mystorm-org/BlackIce-II/README.md

# BlackIce-II

Project documentation can be found in the [project wiki](https://github.com/mystorm-org/BlackIce-II/wiki).
