mystorm-org/BlackIce-II/examples/readme.md

# Examples

* blink

	Blink one LED

* alternate
* button
* count
* position
* random
* rotate

* hello\_world

    FPGA continuously sends "Hello World!" to the serial USB port.

* uart\_loopback

    FPGA receives data from USB2, decodes it, and retransmits it to USB2.

* sram

    An example that shows how to make the FPGA use the external SRAM.

* pll

    An example that shows how to use a PLL to create different clocks.

* pll\_advanced

    A lot more PLL examples.
