mystorm-org/BlackIce-II/examples/hello_world/readme.md

# Hello World!

This example blinks LED1 roughly once every 1.5 seconds.

The design contains a very simply UART TX block.  Whenever the LED blinks, the FPGA also sends "Hello World!" to the USB2 port.

Run "make help" to check out the available options.
