mystorm-org/BlackIce-II/hardware/mystorm.png

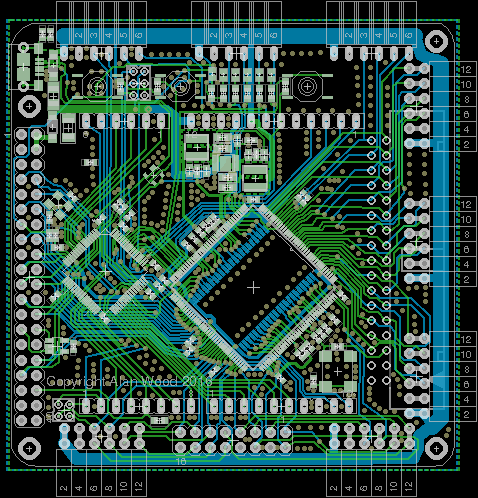
hardware/mystorm.png
