mystorm-org/BlackIce-II/(threads)

Thread 4 (2018-02-24):

Downloading a bitstream over /dev/ttyUSB0 defeatured?

tomverbeure, 2018-02-24:
### Executive summary:

Has bitstream downloading over /dev/ttyUSB0 been defeatured?

If so, this should probably be made more clear!

### The Long Story:

There are plenty of places that mention that you can download a bitstream via both /dev/ttyACM0 (which works for me) and /dev/ttyUSB0.

Here's one such case:
https://gist.github.com/mattvenn/293c3007fae978cfb3c3eb81c7464349

The iceboot source code says the same as well. As can be seen here:
https://github.com/mystorm-org/BlackIce-II/blob/3051631468404d1505e2d82c021b8d2c9acc7d34/firmware/iceboot/iceboot.c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
and here:
https://github.com/mystorm-org/BlackIce-II/blob/3051631468404d1505e2d82c021b8d2c9acc7d34/firmware/iceboot/iceboot.c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

The problem is: I just can't get it to work.

After doing ```stty -F /dev/ttyUSB0 115200```, ```stty -F /dev/ttyUSB0 raw```, and pressing the reset button, I see the following just fine:
```
root@ubuntu-xenial:~/projects/BlackIce-II-mine/examples/blink# cat /dev/ttyUSB0
<Iceboot 0.4>
Setup done
```

And doing ```sudo cat chip.bin > /dev/ttyUSB0``` returns after a while, so I think that's executing fine as well.

But no bitstream is being updated.

Diving further into the ```iceboot``` source code, I see the following in ```setup()```:
https://github.com/mystorm-org/BlackIce-II/blob/3051631468404d1505e2d82c021b8d2c9acc7d34/firmware/iceboot/iceboot.c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

And:
https://github.com/mystorm-org/BlackIce-II/blob/3051631468404d1505e2d82c021b8d2c9acc7d34/firmware/iceboot/iceboot.c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

And in ```loop()```, I don't see anything that's actually accessing the real UART.

So my current conclusion is that this feature simply doesn't exist anymore.

Is that correct?

Thanks!
Tom

folknology, 2018-02-24:
I think Matt Venn's excerpt from ken is rather old (notice the mystorm 0.1). Originally we had no native STM32 USB and had to use either serial adaptors or later the USB/Serial chips like the CH340. Now however with the Native USB via the STM32 we do not need the extra serial adaptor to program the Ice40 bitfile. However many folks frequently build in Uarts as part of their FPGA projects, Thus this becomes the prime use of the 2nd USB feature, we have actively de-featured it on BlackIce II, as it is now hardwired into PMOD1 and the FPGA. It is also still connected to the STM32 and can be used by user programs if they so wish, but for our standard firmware it is unlikely to be activated moving forward.

tomverbeure, 2018-02-24:
Ok!  So my understanding is correct then.

I've already indicated in the documentation that the /dev/ttyUSB0 method doesn't work anymore.

Closing.

Closed 2018-02-24.

Thread 7 (2018-02-25):

Seperate VBUS for both USB connections

folknology, 2018-02-25:
VBUS is currently shared between the two usb connectors, add a diode so each feeds separately to supply.

Thread 10 (2018-03-01):

Update schematic pdf for incorrect and missing items

tomverbeure, 2018-03-01:
* Rename: STM32F103RET6 -> STM32L433RCT6
* Rename: IS62WV25616DBLL-10TLI -> IS61WV25616EDBLL-10TLI
* Add: SN74CBTLV3257 (If that's the one...)

Bonus points: provide PDFs of the PCB and the component placements.

Thread 14 (2018-03-06):

"assign my_signal = 1'bz;" doesn't do what you think it does.

tomverbeure, 2018-03-06:
See the Yosys issue that I just filed:
https://github.com/YosysHQ/yosys/issues/511

```assign my_signal = 1'bz;``` results in an active low output driver.

All current examples are using this for all unused PMOD and other signals.

As a result, a bunch of IOs on the board may be in short-circuit state.

The best example of this is ```PMOD[1]/greset```: this signal is always driven by the CH340G RTS# signal, and it drives a value of 1 (at least when when USB2 is not plugged in). In all examples, ```PMOD[1] = 1'bz```, so it drives a low.

Apparently, the FPGA is a stronger driver than the CH340G on my board, because otherwise no example would work with ```greset``` driving a 1.

Tom

Note: when I fix the issue by not assigning anything to PMOD1, the board is indeed in reset at all times, except when I do "cat /dev/ttyUSB0" or "echo <blah> > /dev/ttyUSB0". But as soon as I cancel the 'cat' operation or as soon as the echo is completed, it goes back into reset.

tomverbeure, 2018-03-10:
Since constant assignments of 1'bz simply don't work, and actually do active harm, they shouldn't be done at all.

What also doesn't work is to keep the output ports but not assign them: that also results in a hard drive to 0. As can be seen in this post-placement result from Arachne:
```
  SB_IO #(
    .PIN_TYPE(6'b011001)
  ) $inst0 (
    .PACKAGE_PIN(B1),
    .D_OUT_0($undef)
  );
```

Also not a good solution: do nothing. Having IOs constantly in contention is just not a good idea.

Here are possible solutions:
* No assignments and no port declarations. I believe that this results in IOs that default to input, with pulp enabled. This is my preference. (Example fix is here: https://github.com/tomverbeure/BlackIce-II/tree/fix_contentions)
* No assignments, but change outputs to inputs. This results in an instantiated IO port that's explicitly set to input, but without pullup:
```
  SB_IO #(
    .PIN_TYPE(6'b000001)
  ) $inst0 (
    .PACKAGE_PIN(B1)
  );
```
* Expliclity instantiate SB_IOs for all unused port.

folknology, 2018-03-27:
I like your fix contentions for the reset (the `assign my_signal = 1'bz;` is a PITA) it is a great idea to sort this out generically for all examples. Perhaps if we use -no-warn on the set_ios ( #9 ) we could remove all other none used io's from the examples?

folknology, 2018-03-29:
Maybe we just use 'inout' rather than 'out' in all cases of tri-stating

folknology, 2018-03-29:
I'm having trouble checking this, just updated yosy after some installation issues on my laptop (I'm remote at the mo), but tri-stating is complicated with yosys - This is an interesting thread around the matter https://github.com/cseed/arachne-pnr/issues/24

folknology, 2018-03-29:
I'm playing around with some of the examples to find a better expression for these

TimRudy, 2021-03-06:
Is this resolved by fix of https://github.com/YosysHQ/yosys/issues/1841, which was generic, in iopadmap?
Just checking in 2021.

tomverbeure, 2021-03-06:
I just reran this as follows:

```
read_verilog test.v
hierarchy
synth_ice40
write_blif test.blif
write_verilog test.out.v
```

And the output was this:
```verilog
(* top =  1  *)
(* src = "test.v:1.1-13.10" *)
module tritest(my_tri_out, my_tri_inout, my_in0, my_in1);
  (* src = "test.v:5.15-5.21" *)
  input my_in0;
  (* src = "test.v:6.15-6.21" *)
  input my_in1;
  (* src = "test.v:3.15-3.27" *)
  inout my_tri_inout;
  (* src = "test.v:2.16-2.26" *)
  output my_tri_out;
  (* src = "test.v:11.31-11.53" *)
  \$_TBUF_  \my_tri_inout_$_TBUF__Y  (
    .A(my_in1),
    .E(my_in0),
    .Y(my_tri_inout)
  );
  assign my_tri_out = 1'hz;
endmodule
```

The `my_tri_out = 1'hz;` is still there.

In my own designs, I pretty much always instantiate IO buffers when I want anything other than pure input or output, so this bug is not an issue for me anymore.

Tom

Thread 23 (2018-03-27):

Optimisation of SRAM memory pinout for subsequent BlackIce revisions

folknology, 2018-03-27:
I notice @lawrie has a  [desire](https://github.com/mystorm-org/BlackIce-II/tree/master/examples/sram) for certain signals RAM_OE and WE being in different groups to enable use of inverted clock function in IO section. However the linked solution ends up using the DDR mode in order to solve the timing issues in another way which may well be more flexible. This therefore is a temporary place holder discussions about any potential optimisations of the SRAM-Ice40 current pinout choices including issues described in the link.  Feel free to discuss..

Thread 25 (2018-08-11):

BlackIce-I support

expipiplus1, 2018-08-11:
I've got a BlackIce-I board (Not sure precisely which revision. I've compiled the firmware and blink examples in this repository and they seem to be working. The post here: https://mystorm.uk/blackice-build-update/ says that some pin assignments have been reassigned. Hopefully the only change necessary will be to use a different pcf file.

Would it make sense to add the original blackice.pcf (found [here](https://github.com/mystorm-org/Guide/blob/master/tutorial/blink/blackice.pcf)) to this repo and make it an option when building?

victzh, 2019-04-17:
I second this. I have Blackice-I board also and I tried to build examples. I built blink example, but it requires not only .pcf file, but chip.v from the same project as well.

Also, it is mentioned somewhere that because of conflict with RAM some PLL modes are unavailable for it. I would like to know more details about it as well.

Thread 26 (2019-12-06):

PicoRV32 example?

sunnystormy, 2019-12-06:
Hello! I've still got my BlackIce-II board and am trying to get Clifford Wolf's PicoRV32 running on it. I'm running into some problems with getting next-pnr to create an "hx4k" pathway (I know that the tutorials recommend arachne-pnr, but that seems to have been deprecated).

If you have any recommendations for getting a risc-v core running on the board, I'd love to hear it! Thank you for your help!

lawrie, 2019-12-06:
--hx8k --package tq144:4k

works for me.

sunnystormy, 2019-12-07:
So, I've modified the Makefile that comes with picorv32 to include the options you've provided, and I end up with:

```
nextpnr-ice40 --hx8k --package tq144:4k --json synth.json --pcf example.pcf --asc example.asc
Info: Importing module top
Info: Rule checker, verifying imported design
Info: Checksum: 0x6c59d296

ERROR: package does not have a pin named 'J3' (on line 1)
ERROR: Loading PCF failed.
0 warnings, 2 errors
make: *** [Makefile:35: example.asc] Error 255
```

Any idea why this is happening? Is it because the pcf file may have the wrong pin configuration?

Thank you for your help!

lawrie, 2019-12-07:
Yes, you were using the wrong pcf file for the Blackice II board.

sunnystormy, 2019-12-07:
@lawrie Thank you for this! I'll move the conversation to a more appropriate venue, as per your suggestion.

Thread 27 (2024-07-30):

Issues with SRAM example

bonnefoi, 2024-07-30:
Hello,

I've a lot of issues with the SRAM example with the io constraints like `sram_addr_to_pad` not known.

When I try to change it to `ADR` in the file `sram_io_ice40`, I've got an error:
`chip.blif:322: fatal error: toplevel inout port 'ADR[0]' connected to tristate buffer and driving a net`

I know that is old tech by now, but I would like to use SRAM for my PicoRV32 that uses only ~12k of BRAM currently.

Let me know if you could help me.
Best regards,
Pierre-Francois.

chenz, 2024-07-30:
I've had issues before with the examples not working with newer versions of the toolchain.

E.g. with Yosys 0.27, I had to add "-top chip" in the Makefile, because it would no longer pick "chip" implicitly as the top level module.

Also, arachne-pnr is still being used in the Makefile, which has been unmaintained for a while so it would not be surprising that it does not work with more recent Yosys output.  You could try to use nextpnr instead.

bonnefoi, 2024-07-31:
Thank you very much for your answer !

I've already encountered the issue with the automatic selection of the top circuit with newer version of yosys, but stupid me, I've tried `-top top`...

It's working now and I can now start to connect it to the SoC.
