mystorm-org/BlackIce-II/hardware/BlackIce.pdf

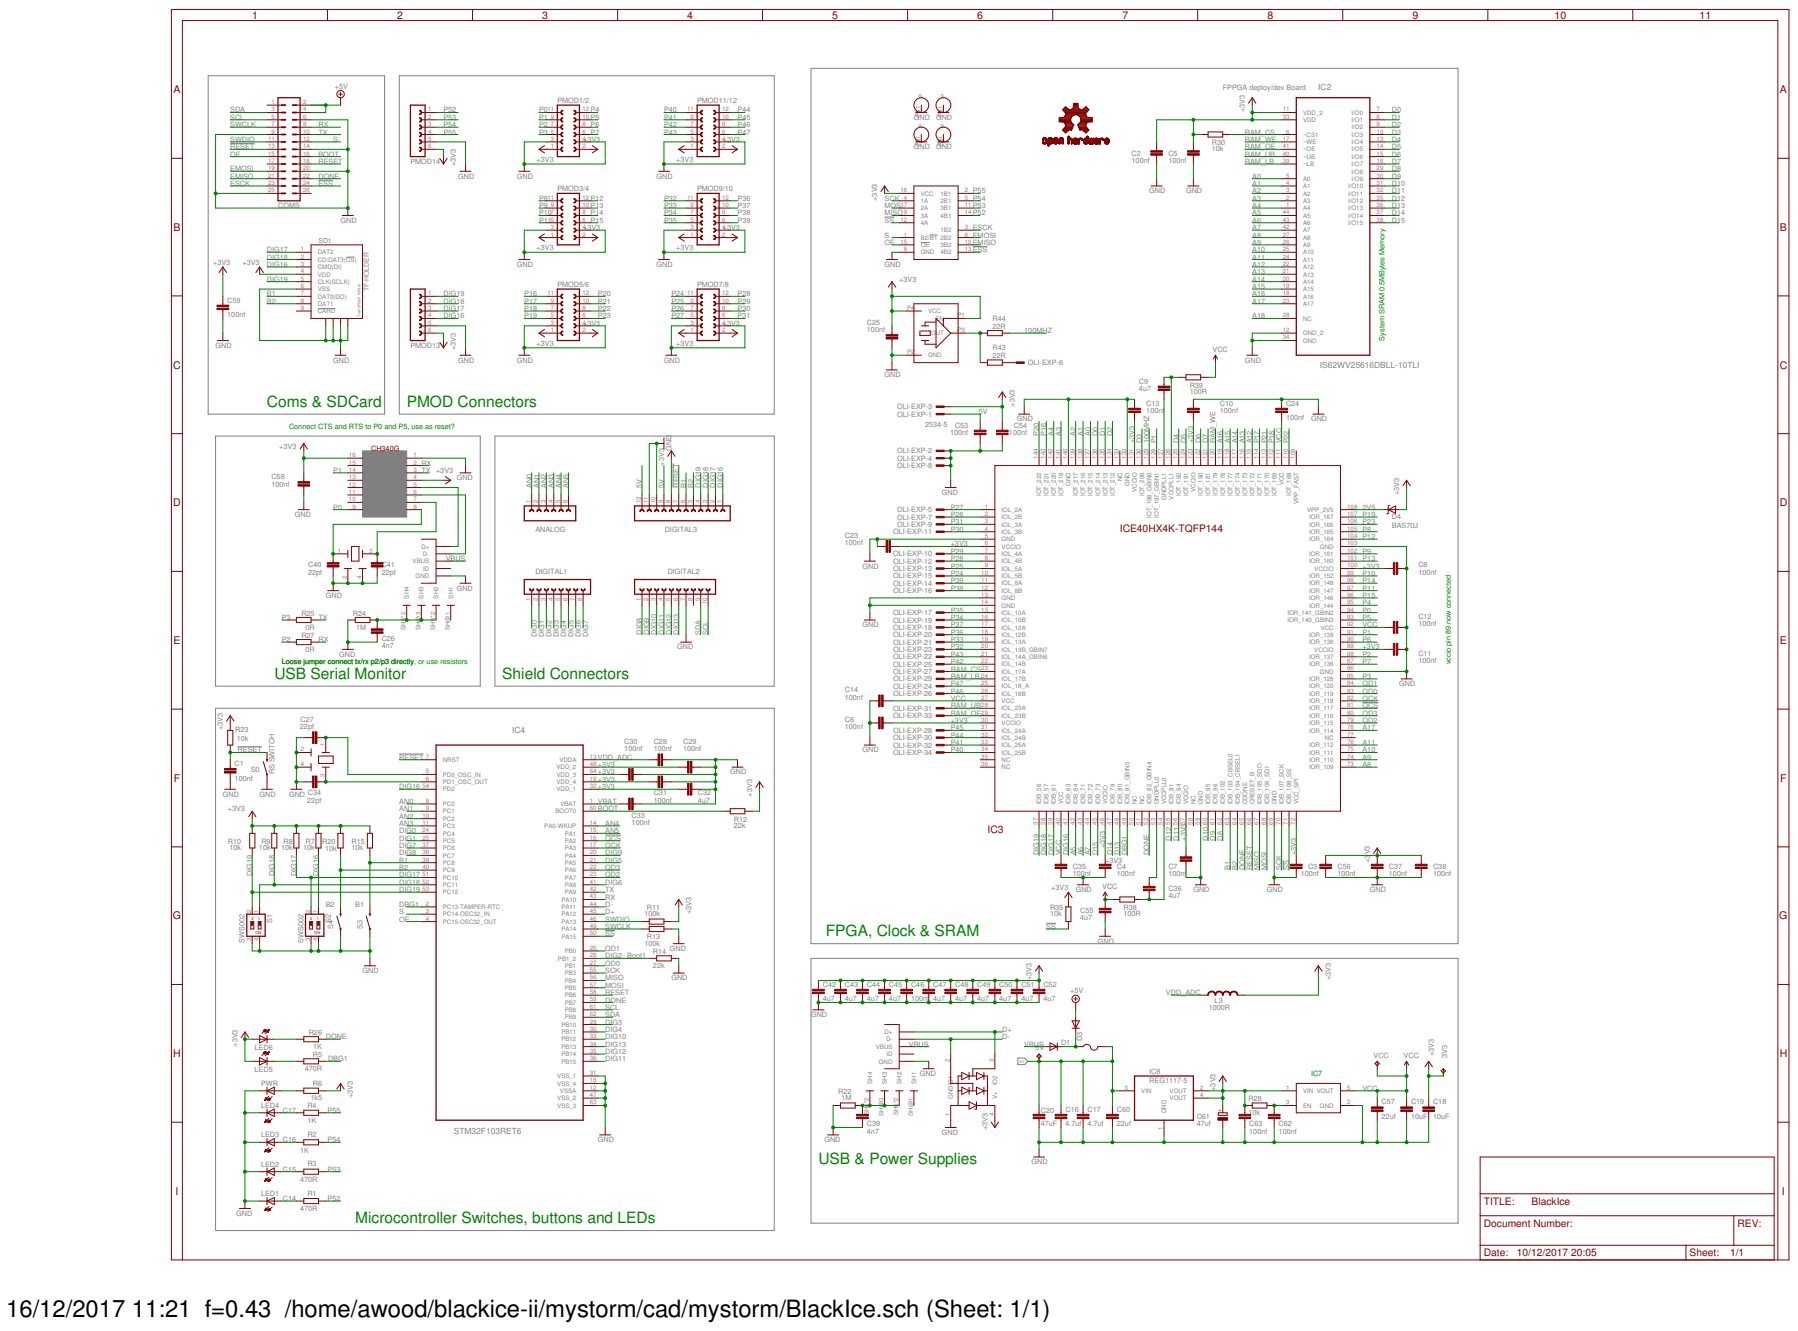
[picture p3: page 1]

FPPGA deploy/dev Board

OLI-EXP-1 OLI-EXP-2 OLI-EXP-3 OLI-EXP-4 OLI-EXP-5

Connect CTS and RTS to P0 and P5, use as reset?

OLI-EXP-8 OLI-EXP-9 OLI-EXP-10 OLI-EXP-11 OLI-EXP-12

IOL_2A
IOL_2B
IOL_3A
IOL_3B
IOL_4A
IOL_4B
OLI-EXP-13 OLI-EXP-15 OLI-EXP-14 OLI-EXP-16 OLI-EXP-17 OLI-EXP-19 OLI-EXP-18 OLI-EXP-20 OLI-EXP-21 OLI-EXP-23 OLI-EXP-27 OLI-EXP-29 OLI-EXP-31 OLI-EXP-33 OLI-EXP-32 OLI-EXP-34

vccio pin 89 now connected

Loose jumper connect tx/rx p2/p3 directly, or use resistors
USB Serial Monitor

16/12/2017 11:21 f=0.43 /home/awood/blackice-ii/mystorm/cad/mystorm/BlackIce.sch (Sheet: 1/1)
