mystorm-org/BlackIce-II/examples/pll_advanced/dual_pll_4clocks/pll.v

module pll_top(
	input  clock_in,
	output clock_out_a,
	output clock_out_b,
	output locked
	);

SB_PLL40_2_PAD #(
		.FEEDBACK_PATH("SIMPLE"),
		.DIVR(4'b0100),		// DIVR =  4
		.DIVF(7'b0101111),	// DIVF = 47
		.DIVQ(3'b101),		// DIVQ =  5
		.FILTER_RANGE(3'b010),	// FILTER_RANGE = 2
	) uut (
		.LOCK(locked),
		.RESETB(1'b1),
		.BYPASS(1'b0),
		.PACKAGEPIN(clock_in),
		.PLLOUTGLOBALA(clock_out_a),
		.PLLOUTGLOBALB(clock_out_b)
		);

endmodule

module pll_bottom(
	input  clock_in,
	output clock_out_a,
	output clock_out_b,
	output locked
	);

SB_PLL40_2F_CORE #(
		.FEEDBACK_PATH("SIMPLE"),
		.DIVR(4'b0100),		// DIVR =  4
		.DIVF(7'b0011111),	// DIVF = 31
		.DIVQ(3'b101),		// DIVQ =  5
		.FILTER_RANGE(3'b010),	// FILTER_RANGE = 2
		.PLLOUT_SELECT_PORTB("GENCLK_HALF")
	) uut (
		.LOCK(locked),
		.RESETB(1'b1),
		.BYPASS(1'b0),
		.REFERENCECLK(clock_in),
		.PLLOUTGLOBALA(clock_out_a),
		.PLLOUTGLOBALB(clock_out_b)
		);

endmodule
