mystorm-org/BlackIce-II/(commit log)

2017-12-23 Added blackIce-II version of iceboot (0.4) , sourcecode and hardware etc..
    [BlackIce.brd, BlackIce.sch, BlackIce_11_10_17.brd, BlackIce_11_10_17.sch, stlink.cfg]
2017-12-23 Update tutorials to use common PCF file, updated BlackIce-II pcf file, fixed button tutorials
    [blackice-ii.pcf, button.v, chip.v]
2018-02-24 Add pin definitions for quad SPI pins.
2018-02-24 Change upload device from /dev/ttyUSB0 to /dev/ttyACM0
2018-02-25 hello world uart_tx example
2018-02-27 uart_loopback example
2018-02-27 Add uart_loopback
2018-03-05 Remove UART from SRAM example.
2018-03-05 Remove uart blocks.
2018-03-05 Button 2 corrupts the SRAM read data
2018-03-24 Fix the comment: the oscillator is actually 100 Mhz
    [blackice-ii.pcf]
