mystorm-org/BlackIce-II/(notices)

Notices in the files:
firmware/Inc/main.h:
COPYRIGHT(c) 2016 STMicroelectronics
(C) COPYRIGHT STMicroelectronics *****END OF FILE
hardware/BlackIce.brd:
Copyright Alan Wood 2017
parts and their libraries:
SparkFun-Passives: Licensing: Creative Commons ShareAlike 4.0 International - https://creativecommons.org/licenses/by-sa/4.0
